AriM224/BlastOpen/README.md

# BlastOpen
Retrofit Blastercard lock entry for dorms with old key-style door locks.
