AriM224/BlastOpen/BOM.csv

Item------------------------ | Description----------------------------------------------------------- | Link--------------------------------------------------------------------- | Qty | Cost
SEEED XAIO rp2040 | Main controller for everything. | https://www.seeedstudio.com/XIAO-RP2040-v1-0-p-5026.html | 1 | $5.40
Motor Driver 12v 3A w/ Builtin 5V reg | To drive the motor at higher power | https://www.seeedstudio.com/MDD3A-p-4274.html | 1 | $8.50
90 degree gear Motor 12v w/ Gearbox & Encoder | Motor with gearbox, high torque but decent speed, encoder | https://www.amazon.com/Turbine-Motor-Encoder-Strong-self-Locking/dp/B08JQKVSMX/ | 1 | $20.00
Wire? | Labriola I think has free wire |  |  | $0.00
NFC Reader | Ari has some readers | https://www.amazon.com/SunFounder-Mifare-Reader-Arduino-Raspberry/dp/B07KGBJ9VG/ | 1 | $9.00
Buttons | 2 buttons, 1 to flash a new card, 1 to test open | https://www.seeedstudio.com/Grove-Button.html | 2 | $3.00
RGB LED | Indicator Light through eyehole |  | 1 | $0.00
DC wall adapter 12v |  | https://www.amazon.com/12V-Power-Supply-Universal-5-5x2-5mm/dp/B0DLWB2TPR/ | 1 | $9.00
Totals: |  |  | 7 | $54.90
