AriM224/BlastOpen/CAD/Main_Case.SLDASM

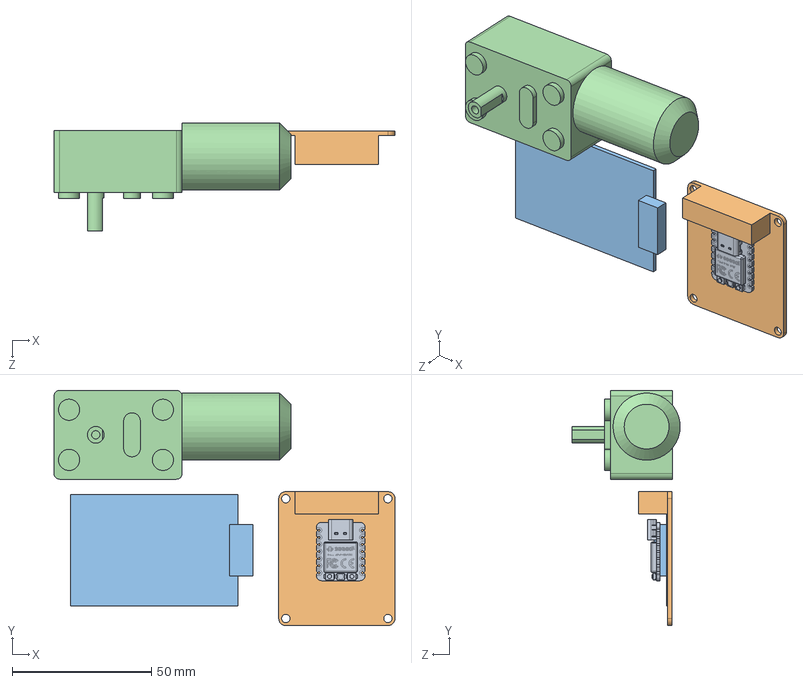
[picture p1: CAD file, 2025-09-25]
CAD/Main_Case.SLDASM
122.4 x 84.4 x 38.9 mm
Gear_Motor
RFID-RC522
Motor_Driver
Seeed_Studio_RP2040
