AriM224/BlastOpen/CAD/Motor_Pulley_Main_Case.3mf

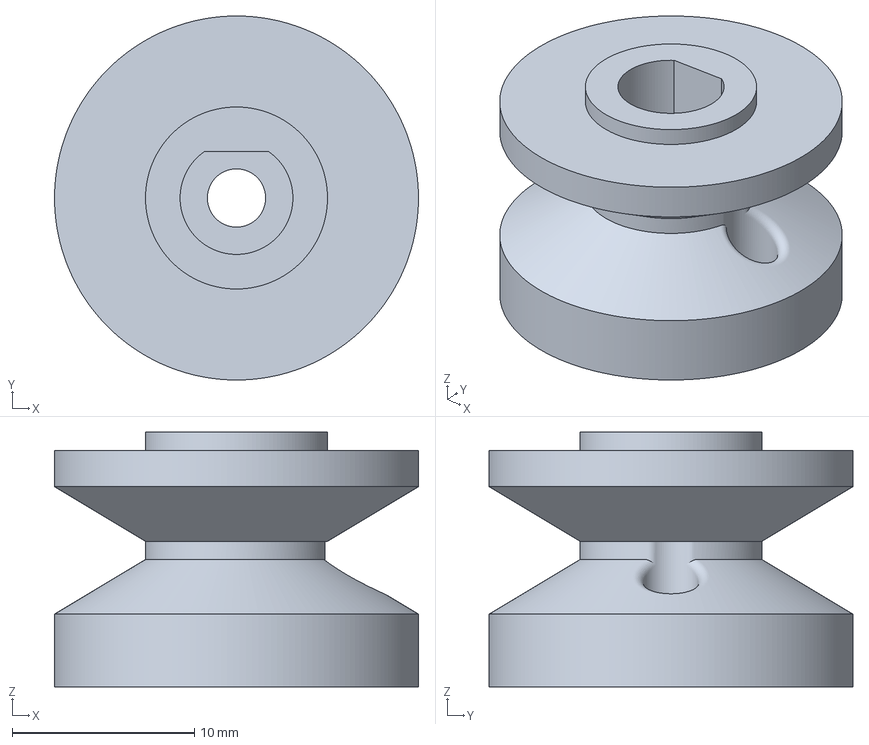
[picture p2: CAD file, 2025-09-15]
CAD/Motor_Pulley_Main_Case.3mf
20.0 x 20.0 x 14.0 mm
