AriM224/BlastOpen/CAD/Case.STEP

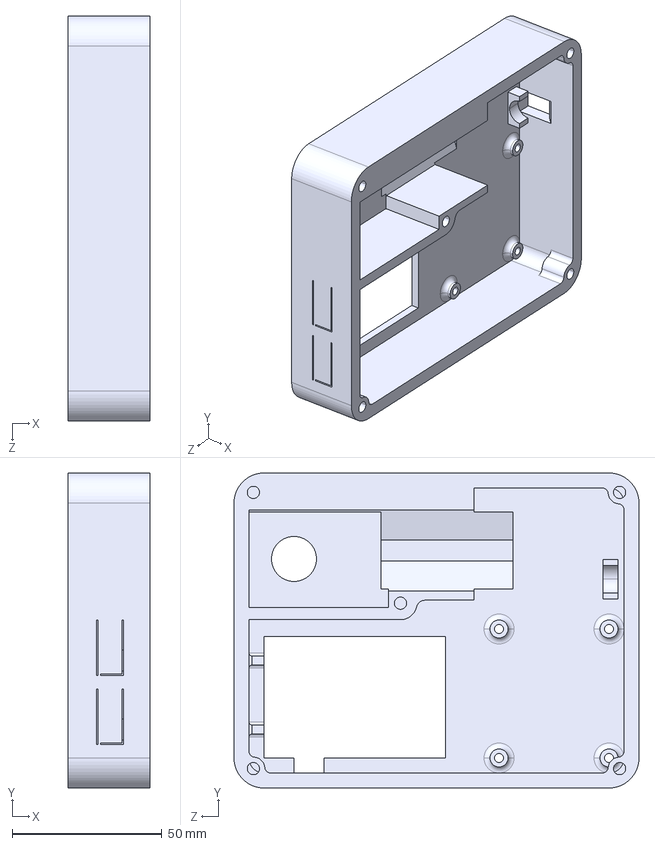
[picture p3: CAD file, 2025-09-25]
CAD/Case.STEP
27.4 x 105.0 x 135.0 mm
