AriM224/BlastOpen/CAD/Door_handle_hook.STEP

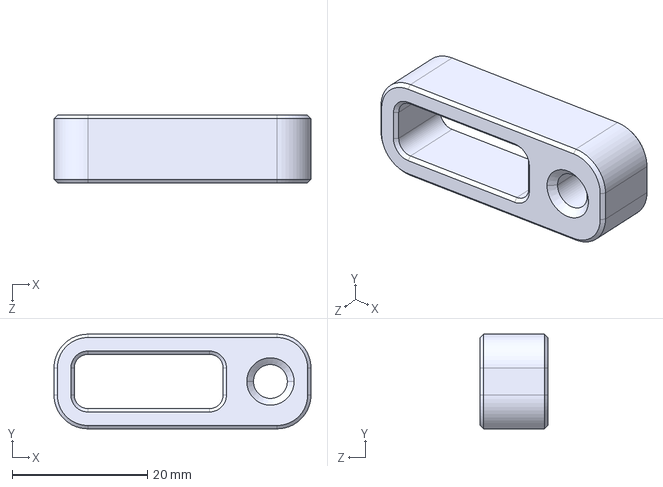
[picture p4: CAD file, 2025-09-25]
CAD/Door_handle_hook.STEP
38.0 x 14.0 x 10.0 mm
