AriM224/BlastOpen/CAD/Top_Plate.STEP

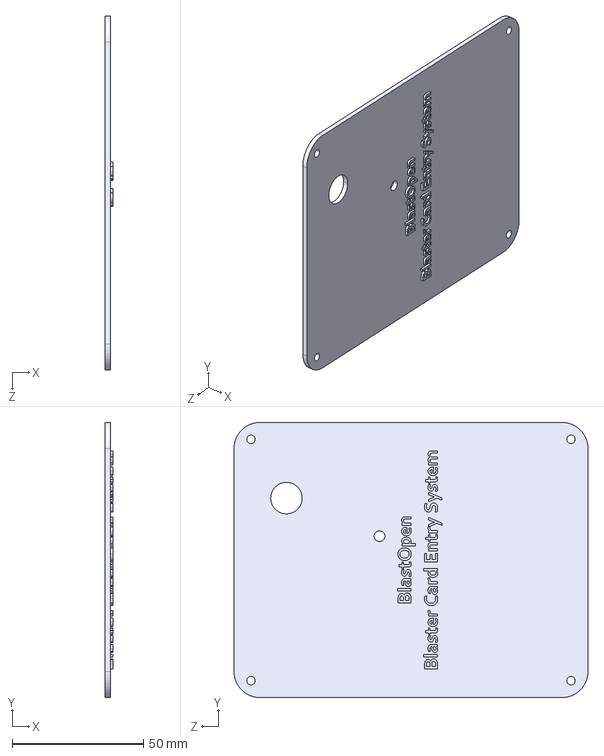
[picture p5: CAD file, 2025-09-15]
CAD/Top_Plate.STEP
3.00 x 105.0 x 135.0 mm
