AriM224/BlastOpen/CAD/Gear_Motor.SLDPRT

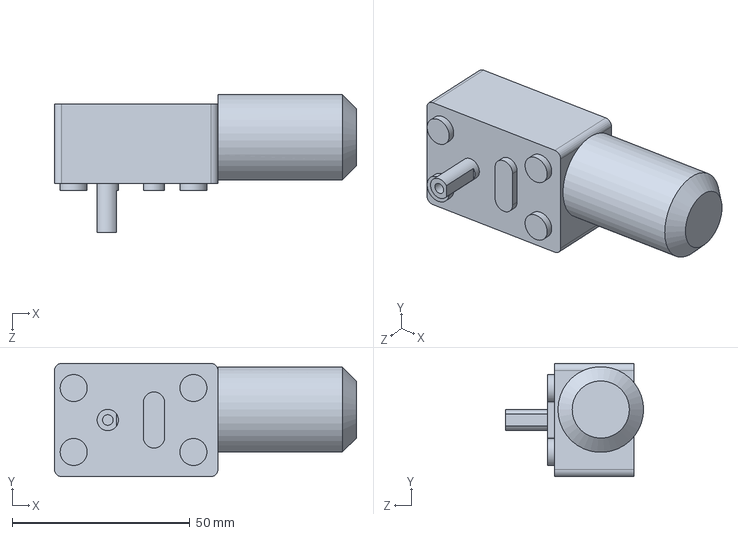
[picture p6: CAD file, 2025-09-11]
CAD/Gear_Motor.SLDPRT
85.0 x 31.9 x 38.9 mm
