AriM224/BlastOpen/CAD/RFID-RC522.SLDPRT

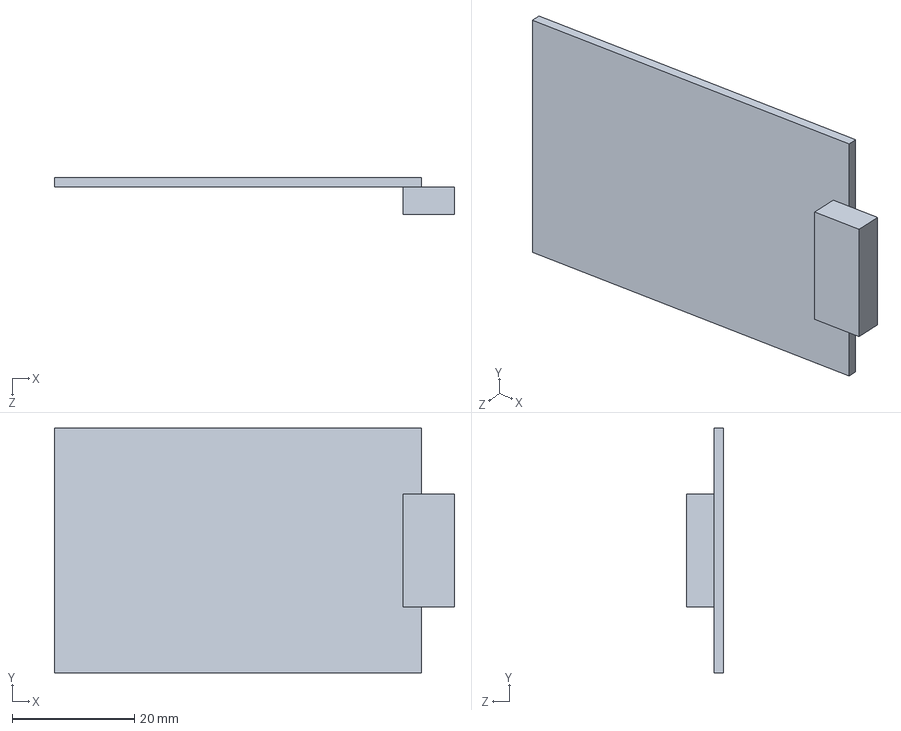
[picture p7: CAD file, 2025-09-11]
CAD/RFID-RC522.SLDPRT
65.4 x 40.0 x 6.10 mm
