AriM224/BlastOpen/CAD/Seeed_Studio_RP2040.SLDPRT

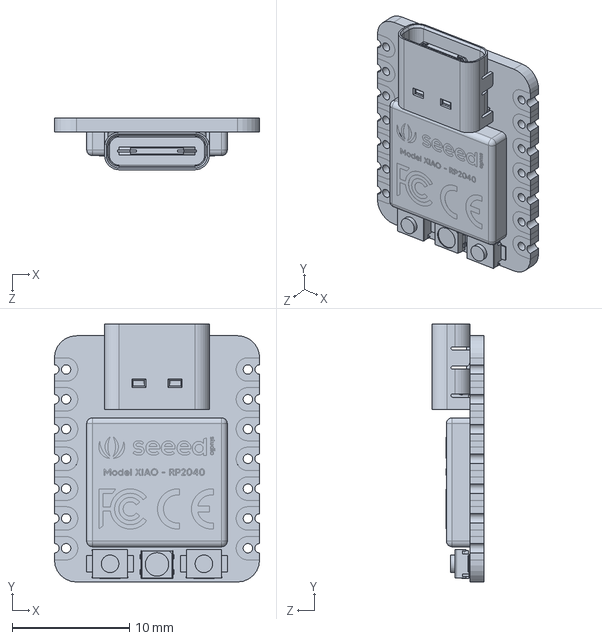
[picture p8: CAD file, 2025-09-11]
CAD/Seeed_Studio_RP2040.SLDPRT
17.5 x 22.0 x 4.40 mm
