AriM224/BlastOpen/CAD/Motor_Driver.SLDPRT

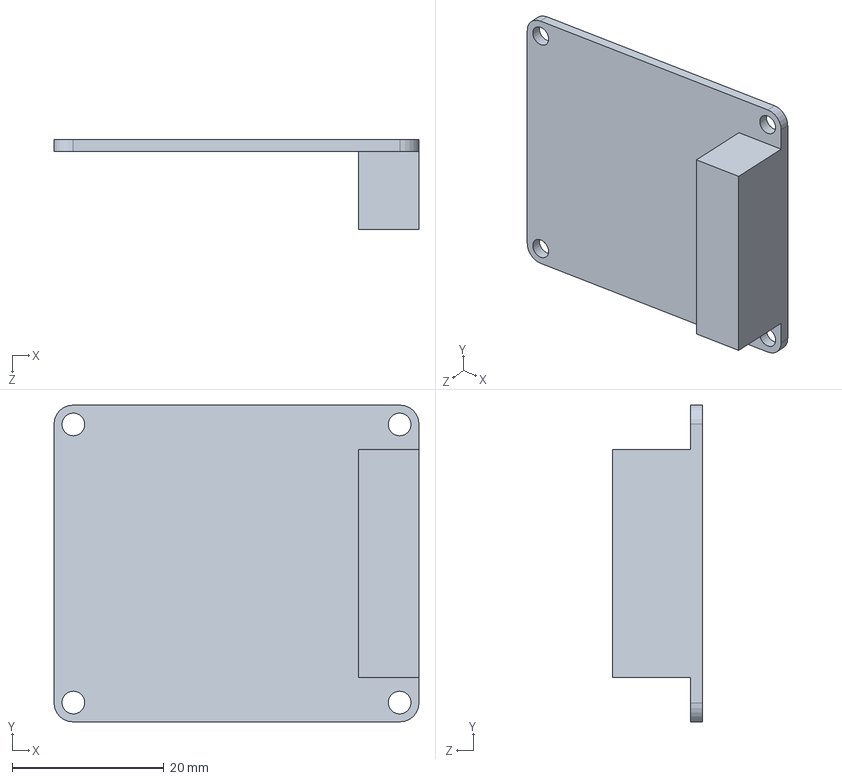
[picture p9: CAD file, 2025-09-11]
CAD/Motor_Driver.SLDPRT
48.1 x 41.8 x 11.9 mm
