AriM224/BlastOpen/(list of files, cad)

Other CAD files:
CAD/Motor_Pulley.STEP
CAD/Door_handle_hook.3mf
CAD/Door_handle_hook.SLDPRT
CAD/Main_Case.3mf
