AriM224/BlastOpen/BlastOpen Schematic/BlastOpen Schematic.pdf

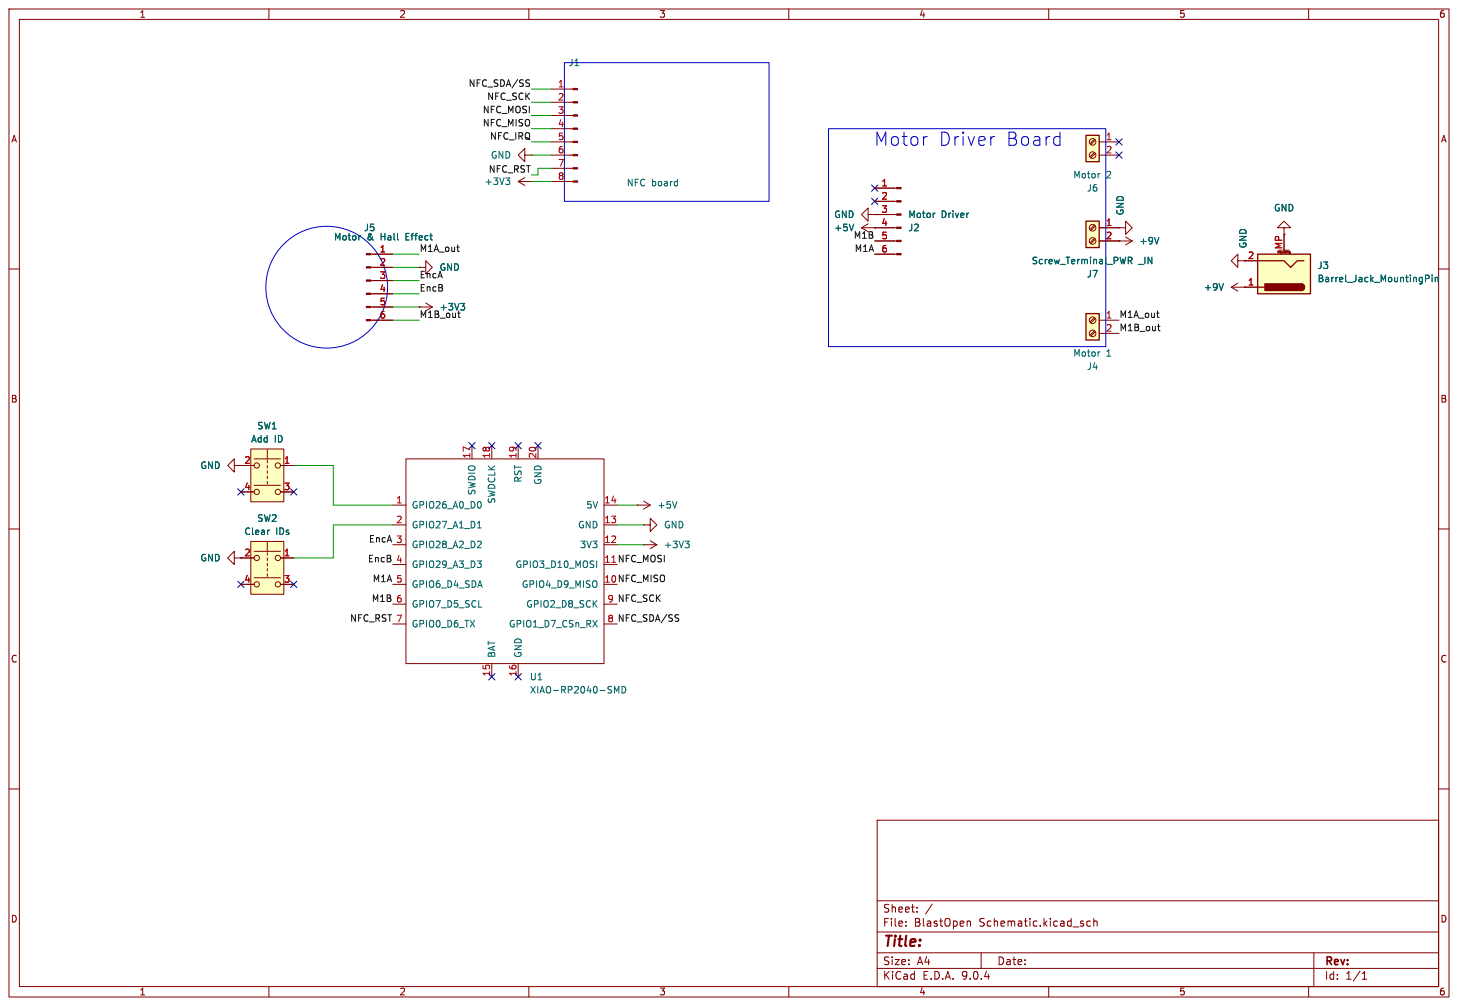
[picture p10: page 1]

Id: 1/1 Title: File: BlastOpen Schematic.kicad_sch Sheet: /
