AriM224/BlastOpen/BlastOpen Schematic/BlastOpen Schematic.kicad_sch

## KiCad design BlastOpen Schematic/BlastOpen Schematic.kicad_sch (2025-09-19)

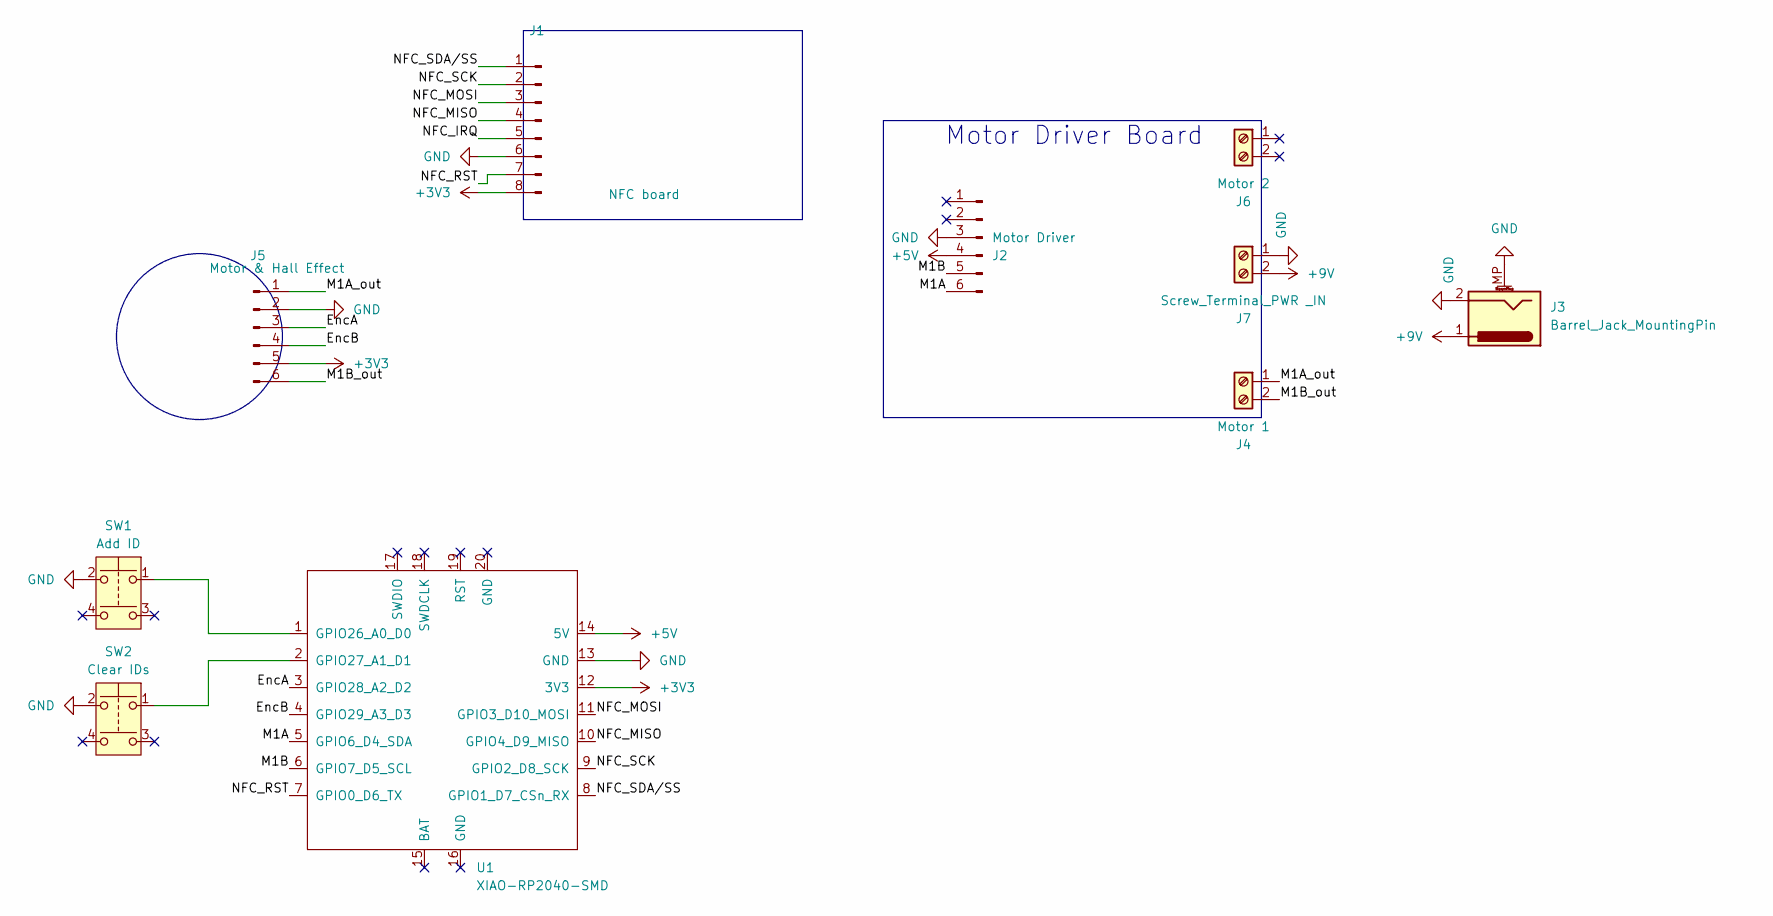
[picture p11: schematic BlastOpen Schematic.kicad_sch]

Parts:
J1: NFC board
J2: Motor Driver
J3: Barrel_Jack_MountingPin
J4: Motor 1
J5: Motor & Hall Effect
J6: Motor 2
J7: Screw_Terminal_PWR _IN
SW1: Add ID
SW2: Clear IDs
U1: XIAO-RP2040-SMD

Connections:
+3V3: J1.8, J5.5, U1.12 (3V3)
+5V: J2.4, U1.14 (5V)
+9V: J3.1, J7.2
EncA: J5.3, U1.3 (GPIO28_A2_D2)
EncB: J5.4, U1.4 (GPIO29_A3_D3)
GND: J1.6, J2.3, J3.2, J3.MP (MountPin), J5.2, J7.1, SW1.2, SW2.2, U1.13 (GND)
M1A: J2.6, U1.5 (GPIO6_D4_SDA)
M1A_out: J4.1, J5.1
M1B: J2.5, U1.6 (GPIO7_D5_SCL)
M1B_out: J4.2, J5.6
NFC_IRQ: J1.5
NFC_MISO: J1.4, U1.10 (GPIO4_D9_MISO)
NFC_MOSI: J1.3, U1.11 (GPIO3_D10_MOSI)
NFC_RST: J1.7, U1.7 (GPIO0_D6_TX)
NFC_SCK: J1.2, U1.9 (GPIO2_D8_SCK)
NFC_SDA/SS: J1.1, U1.8 (GPIO1_D7_CSn_RX)
unnamed: SW1.1, U1.1 (GPIO26_A0_D0)
unnamed: SW2.1, U1.2 (GPIO27_A1_D1)

Notes on the sheet:
Motor Driver Board
