AriM224/BlastOpen/(commit log)

2025-09-02 Initial Bill of Materials
    [BOM.csv]
2025-09-06 Updated link for SEEED XAio from mouser
    [BOM.csv]
2025-09-06 Added amazon nfc reader link
    [BOM.csv]
2025-09-07 Updated links to mainly mouser or amazon products to reduce shipping cost
    [BOM.csv]
2025-09-11 Created SolidWorks CAD files of components
    [Gear_Motor.SLDPRT, Motor_Driver.SLDPRT, RFID-RC522.SLDPRT, Seeed_Studio_RP2040.SLDPRT]
2025-09-15 Mostly finished with the main case. Step files ready for 3d printing
    [Case.STEP, Main_Case.3mf, Main_Case.SLDASM, Motor_Pulley.STEP, Motor_Pulley_Main_Case.3mf, Top_Plate.STEP]
2025-09-19 Added wiring Schematic
    [BlastOpen Schematic.kicad_sch]
2025-09-19 Export PDF of schematic
2025-09-19 Updated BOM with shorter links
    [BOM.csv]
2025-09-25 updated CAD files
    [Case.STEP, Door_handle_hook.3mf, Door_handle_hook.SLDPRT, Door_handle_hook.STEP, Main_Case.3mf, Main_Case.SLDASM]
2025-10-04 Updated code to allow access editing and motor movement
2025-10-10 Added Proportional Controller for motor
